elfremdrift/Vehicle-charge-interface/State diagram.pdf

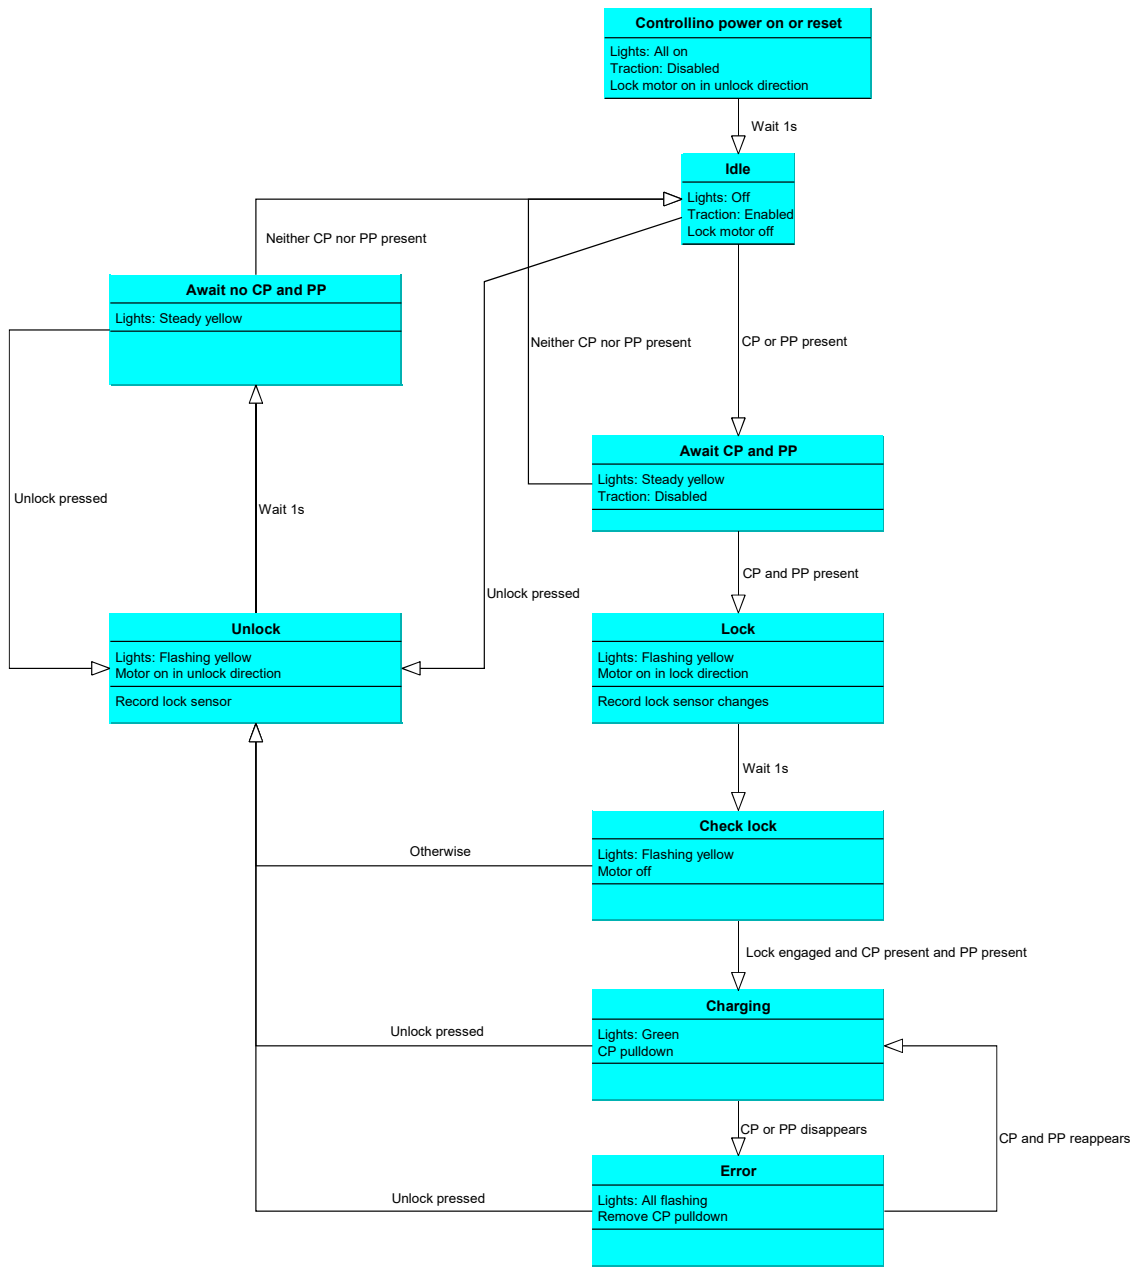
[picture p1: figure]
Idle; Lights: Off Traction: Enabled Lock motor off; Await CP and PP; Lights: Steady yellow Traction: Disabled; Lock; Lights: Flashing yellow Motor on in lock direction; Record lock sensor changes; Check lock; Lights: Flashing yellow Motor off; Unlock; Lights: Flashing yellow Motor on in unlock direction; Record lock sensor; Charging; Lights: Green CP pulldown; Await no CP and PP; Lights: Steady yellow; Error; Lights: All flashing Remove CP pulldown; Controllino power on or reset; Lights: All on Traction: Disabled Lock motor on in unlock direction; Neither CP nor PP present; CP or PP present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

Lock engaged and CP present and PP present
