elfremdrift/Vehicle-charge-interface/Specification/AD value calculations.xlsx

Vehicle charge interface - AD value calculations
CP: | 791.6666667 | 13
 | 760 | 12 | 0.03157894737 | 728.3333333 | - | 791.6666667
 | 728.3333333 | 11
 | 696.6666667 | 10
 | 665 | 9 |  | 633.3333333 | - | 696.6666667
 | 633.3333333 | 8
 | 601.6666667 | 7
 | 570 | 6 |  | 538.3333333 | - | 601.6666667
 | 538.3333333 | 5
 | 31.66666667 | -11
 | 0 | -12 |  | 0 | - | 31.66666667
PP: | 800 | ∞
 | 673
 | 640 | 1500 |  | 607 | - | 673
 | 607
 | 594.9047619
 | 561.9047619 | 680 |  | 528.9047619 | - | 594.9047619
 | 528.9047619
 | 505.1311475
 | 472.1311475 | 220 |  | 439.1311475 | - | 505.1311475
 | 439.1311475
S1: | 800 | ∞
 | 733.7518797
 | 700.7518797 | 10000 |  | 667.7518797 | - | 733.7518797
 | 667.7518797
 | 526.0232558
 | 493.0232558 | 1000 |  | 460.0232558 | - | 526.0232558
 | 460.0232558
