elfremdrift/Vehicle-charge-interface/Schematic.pdf

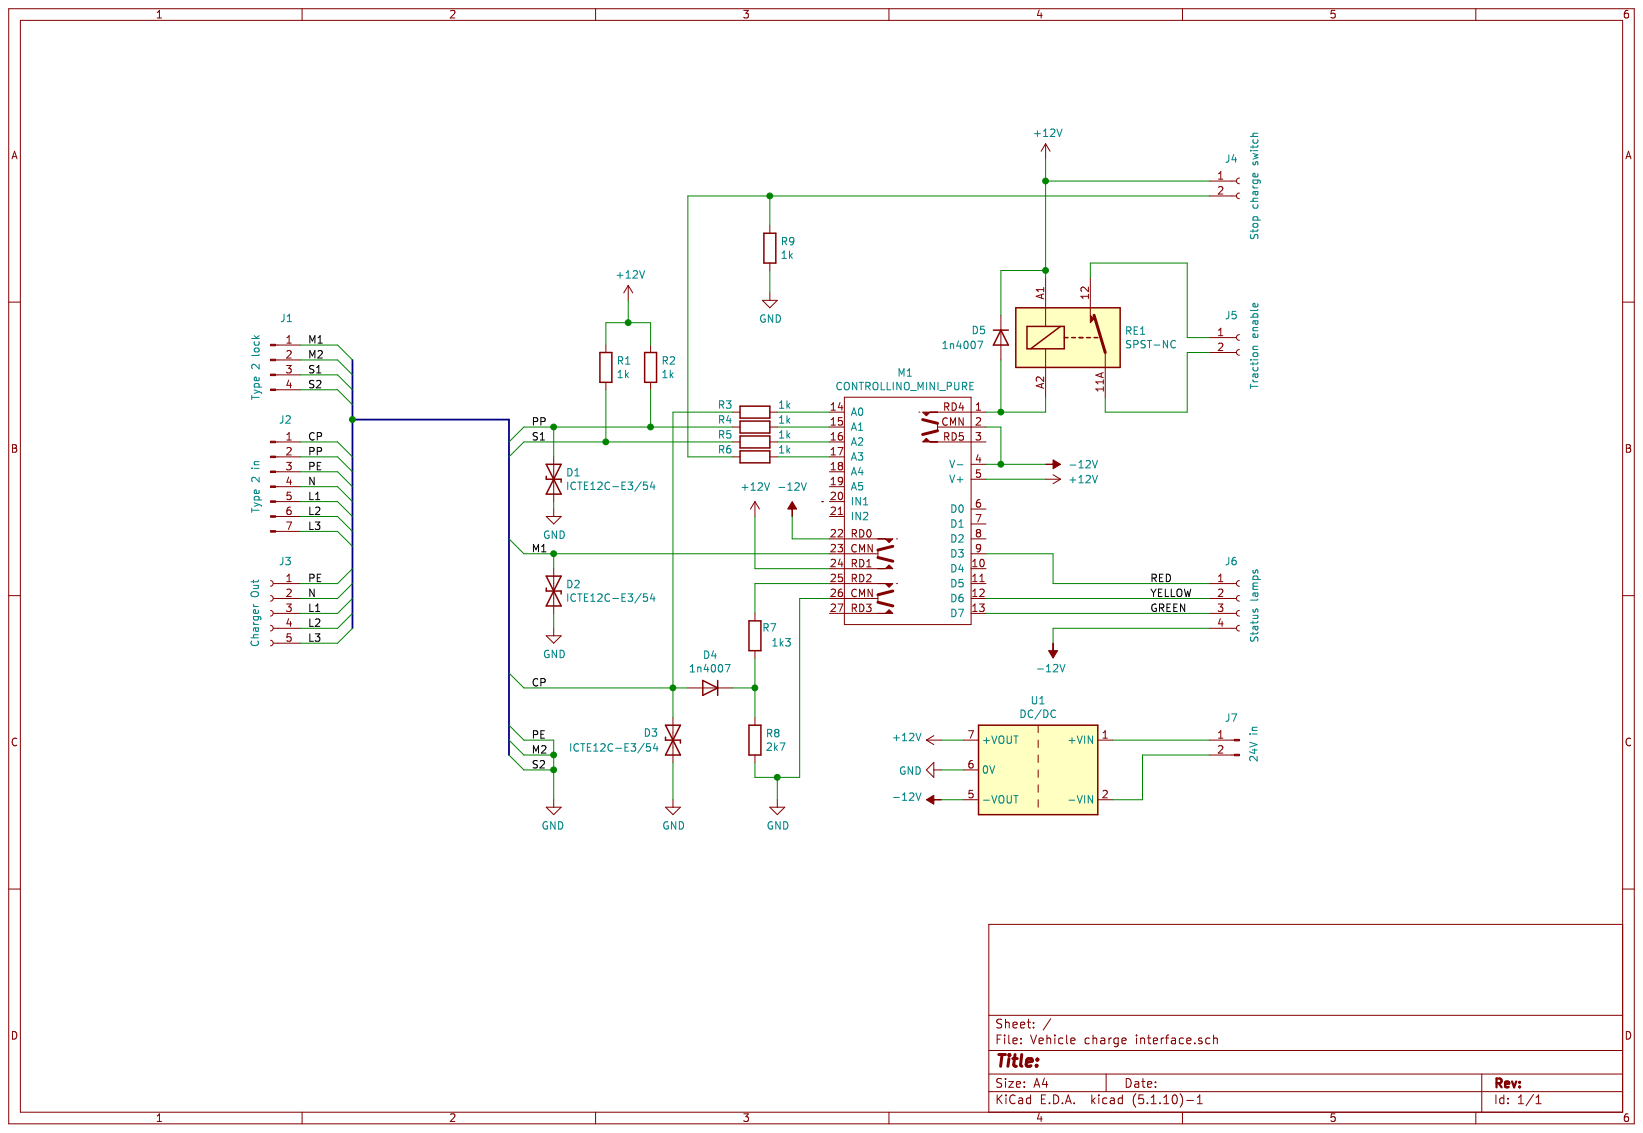
[picture p2: page 1]
