elfremdrift/Vehicle-charge-interface/Schematic/Vehicle charge interface.kicad_pcb

## KiCad design Schematic/Vehicle charge interface.kicad_pcb (2023-02-01)

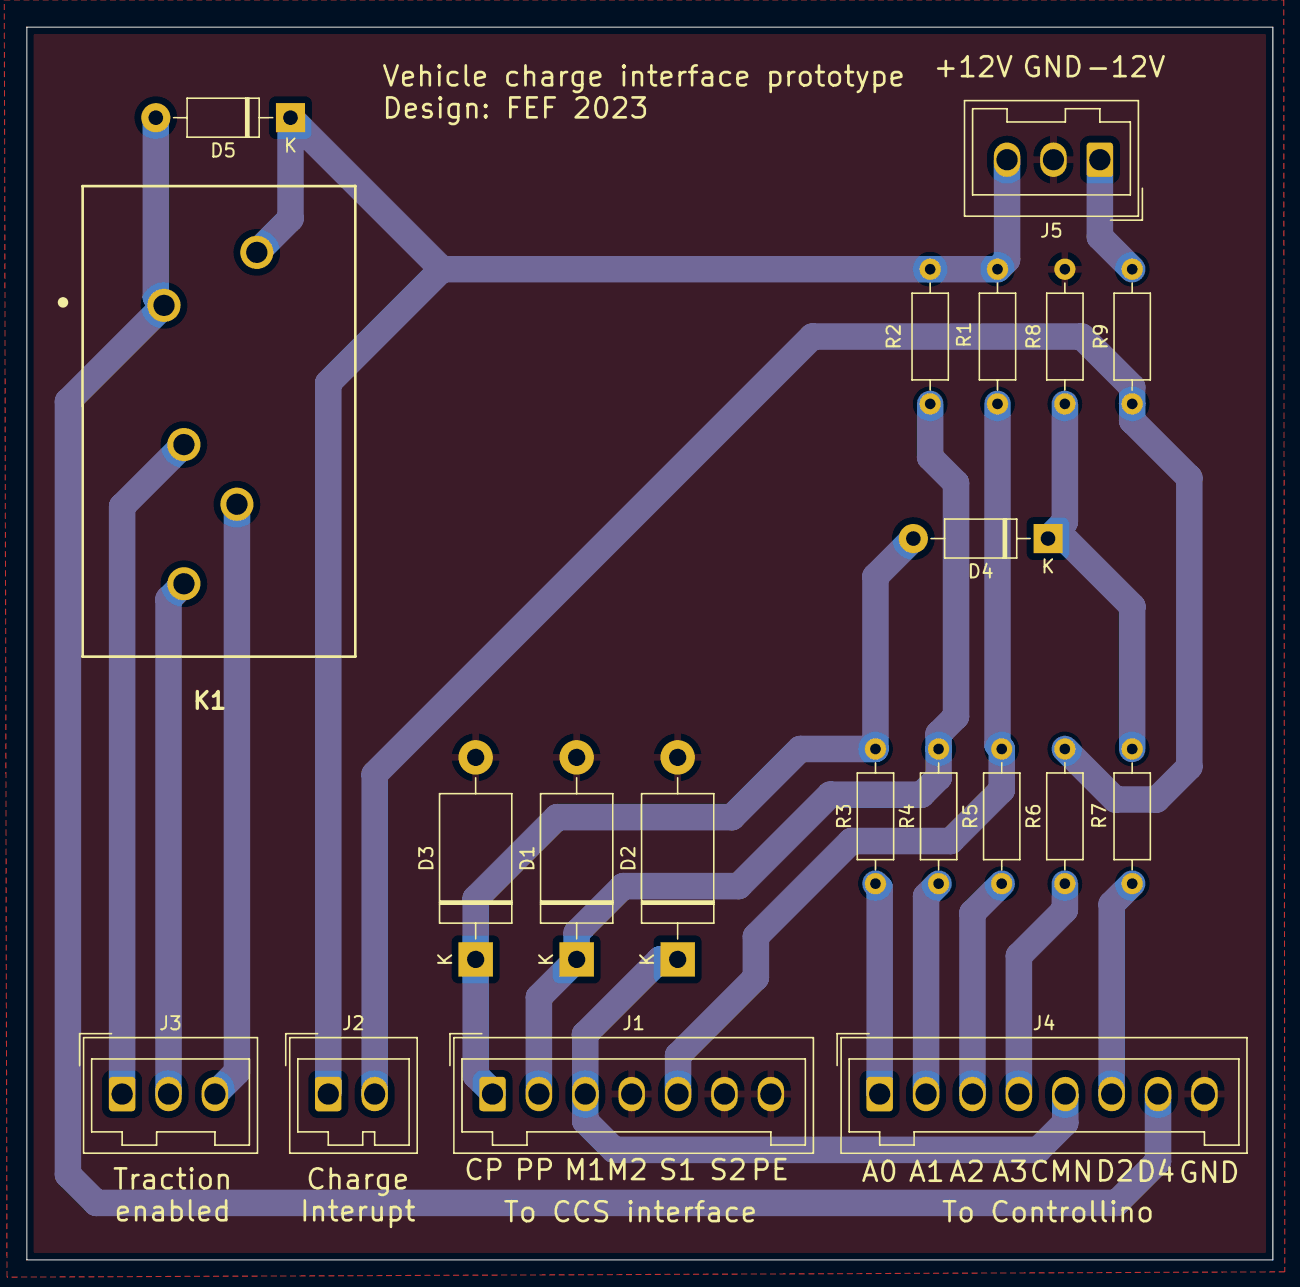
[picture p3: board Vehicle charge interface.kicad_pcb from above]

Board: 2 copper layers, 94.0 x 93.0 mm, 20 parts (0 on the bottom side), 18 nets.

Parts:
D1, D2, D3: ICTE12C-E3/54; D_DO-201_P15.24mm_Horizontal
D4, D5: 1n4007; D_DO-41_SOD81_P10.16mm_Horizontal
J1: Type 2 lock; Wago_734-137_1x07_P3.50mm_Vertical
J2: Stop charge switch; Wago_734-132_1x02_P3.50mm_Vertical
J3: Traction enable; Wago_734-133_1x03_P3.50mm_Vertical
J4: To Controllino; Wago_734-138_1x08_P3.50mm_Vertical
J5: Power in; Wago_734-133_1x03_P3.50mm_Vertical
K1: OMRON_P2R-05P; P2R-05P
R1: 3k3; R_Axial_DIN0207_L6.3mm_D2.5mm_P10.16mm_Horizontal
R2, R3, R4, R5, R6, R9: 1k; R_Axial_DIN0207_L6.3mm_D2.5mm_P10.16mm_Horizontal
R7: 1k3; R_Axial_DIN0207_L6.3mm_D2.5mm_P10.16mm_Horizontal
R8: 2k7; R_Axial_DIN0207_L6.3mm_D2.5mm_P10.16mm_Horizontal

Connections:
+12V: D5.1 (K), J2.1, J5.3, K1.5, R1.1, R2.1
-12V: J5.1, R9.2
/A0: J4.1, R3.1
/A1: J4.2, R4.1
/A2: J4.3, R5.1
/A3: J4.4, R6.1
/CMN: D2.1 (A1), J1.3, J4.5
/CP: D3.1 (A1), D4.2 (A), J1.1, R3.2
/D2: J4.6, R7.2
/D4: D5.2 (A), J4.7, K1.1
/PP: D1.1 (A1), J1.2, R2.2, R4.2
/S1: J1.5, R1.2, R5.2
GND: D1.2 (A2), D2.2 (A2), D3.2 (A2), J1.4, J1.6, J1.7, J4.8, J5.2, R8.2
unnamed: D4.1 (K), R7.1, R8.1
unnamed: J2.2, R6.2, R9.1
unnamed: J3.1, K1.2
unnamed: J3.2, K1.3
unnamed: J3.3, K1.4
