elfremdrift/Vehicle-charge-interface/(commit log)

2022-11-16 Added controller to schematics
    [Vehicle charge interface.sch]
2022-11-23 Main parts of schematics added
    [Vehicle charge interface.sch]
2022-11-29 Finished most of schematics
    [Vehicle charge interface.sch]
2022-11-29 Added PDF-version of schematic
2022-11-29 Added stop switch
    [Vehicle charge interface.sch]
2022-12-04 Setting up directory structure
    [Vehicle charge interface.kicad_pcb, Vehicle charge interface.sch]
2022-12-06 Initial arduino sketch with a bit of AD support
2022-12-07 Added timer functions
2022-12-09 Added timer setup for CP measurement
2022-12-10 Timer and AD now working together to measure all values
2022-12-11 Added input filter class
2022-12-12 Update input filters with measured values
2022-12-12 Added spreadsheet with AD threshold value calculations
    [AD value calculations.xlsx]
2022-12-12 Change S1 pullup (R1) to 3k3
    [Vehicle charge interface.sch]
2022-12-14 Fixes after test
    [Vehicle charge interface.sch]
2022-12-21 Added "cannot lock" explicit error state w/red flash
    [state.cpp]
2022-12-21 Replaced controllino with connectors to prepare for PCB
    [Vehicle charge interface.sch]
2022-12-28 Wider tolerances for AD measurements; avoid unlock loop
    [ad.cpp, definitions.h, state.cpp]
2023-01-04 Initial PCB layout
    [Vehicle charge interface.kicad_pcb, Vehicle charge interface.sch]
2023-02-01 Singlesided layout - upgraded to KiCad 6
    [Vehicle charge interface.kicad_pcb, Vehicle charge interface.kicad_sch, Vehicle charge interface.sch]
2023-03-01 Fix hanging yellow lamp after failed plug insertion
    [state.cpp]
2023-09-24 Added separate wiring diagram
    [Vehicle charge interface.kicad_sch, Wiring diagram.kicad_sch]
